watsonboyett/CarTalk/hardware/CarTalk.brd

## EAGLE design hardware/CarTalk.brd (2017-12-25)

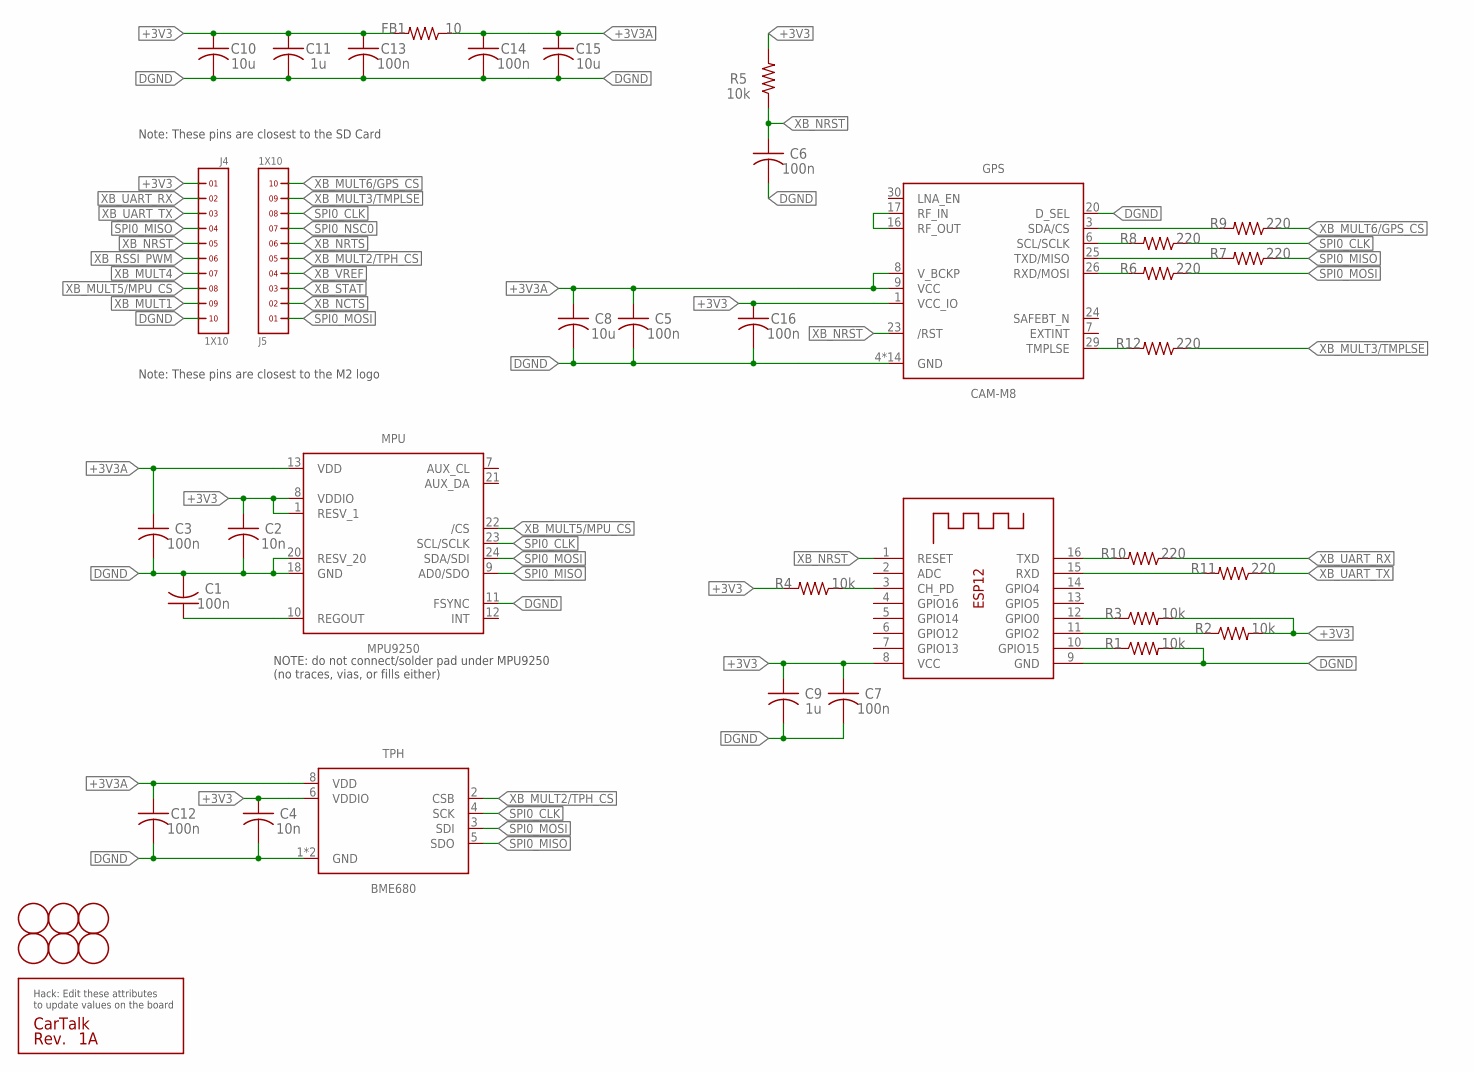
[picture p1: schematic CarTalk.sch]

Parts:
C1, C3, C5, C6, C7, C12, C13, C14, C16: 100n; C0603
C2, C4: 10n; C0603
C8, C10, C15: 10u; C0805
C9, C11: 1u; C0603
FB1: 10; R0603
GPS: CAM-M8
J4, J5: 1X10
MPU: MPU9250; QFN24-NP
R1, R2, R3, R4, R5: 10k; R0603
R6, R7, R8, R9, R10, R11, R12: 220; R0603
TPH: BME680; BME-DFN8
U$5: SILK_QC
U$6, U$7, U$8, U$9, U$10, U$11: FIDUCIAL; FIDUCIAL_1MM
WIFI: ESP-12

Connections:
+3V3: C2.1, C4.1, C7.1, C9.1, C10.1, C11.1, C13.1, C16.1, FB1.2, GPS.1 (VCC_IO), J4.1, MPU.1 (RESV_1), MPU.8 (VDDIO), R1.2, R2.2, R4.2, R5.2, TPH.6 (VDDIO), WIFI.8 (VCC)
+3V3A: C3.1, C5.1, C8.1, C12.1, C14.1, C15.1, FB1.1, GPS.8 (V_BCKP), GPS.9 (VCC), MPU.13 (VDD), TPH.8 (VDD)
DGND: C1.2, C2.2, C3.2, C4.2, C5.2, C6.2, C7.2, C8.2, C9.2, C10.2, C11.2, C12.2, C13.2, C14.2, C15.2, C16.2, GPS.4 (GND), GPS.5 (GND), GPS.10 (GND), GPS.11 (GND), GPS.12 (GND), GPS.13 (GND), GPS.14 (GND), GPS.15 (GND), GPS.18 (GND), GPS.19 (GND), GPS.20 (D_SEL), GPS.21 (GND), GPS.22 (GND), GPS.27 (GND), GPS.31 (GND), J4.10, MPU.11 (FSYNC), MPU.18 (GND), MPU.20 (RESV_20), R3.2, TPH.1 (GND), TPH.7 (GND), WIFI.9 (GND)
unnamed: C1.1, MPU.10 (REGOUT)
unnamed: R1.1, WIFI.12 (GPIO0)
unnamed: R2.1, WIFI.11 (GPIO2)
unnamed: R3.1, WIFI.10 (GPIO15)
unnamed: R4.1, WIFI.3 (CH_PD)
unnamed: GPS.26 (RXD/MOSI), R6.2
unnamed: GPS.25 (TXD/MISO), R7.2
unnamed: GPS.6 (SCL/SCLK), R8.2
unnamed: GPS.3 (SDA/CS), R9.2
unnamed: GPS.16 (RF_OUT), GPS.17 (RF_IN)
unnamed: R10.2, WIFI.16 (TXD)
unnamed: R11.2, WIFI.15 (RXD)
unnamed: GPS.29 (TMPLSE), R12.2
SPI0_CLK: J5.8, MPU.23 (SCL/SCLK), R8.1, TPH.4 (SCK)
SPI0_MISO: J4.4, MPU.9 (AD0/SDO), R7.1, TPH.5 (SDO)
SPI0_MOSI: J5.1, MPU.24 (SDA/SDI), R6.1, TPH.3 (SDI)
SPI0_NSC0: J5.7
XB_MULT1: J4.9
XB_MULT2/TPH_CS: J5.5, TPH.2 (CSB)
XB_MULT3/TMPLSE: J5.9, R12.1
XB_MULT4: J4.7
XB_MULT5/MPU_CS: J4.8, MPU.22 (/CS)
XB_MULT6/GPS_CS: J5.10, R9.1
XB_NCTS: J5.2
XB_NRST: C6.1, GPS.23 (/RST), J4.5, R5.1, WIFI.1 (RESET)
XB_NRTS: J5.6
XB_RSSI_PWM: J4.6
XB_STAT: J5.3
XB_UART_RX: J4.2, R10.1
XB_UART_TX: J4.3, R11.1
XB_VREF: J5.4

Notes on the sheet:
Note: These pins are closest to the SD Card
Note: These pins are closest to the M2 logo
NOTE: do not connect/solder pad under MPU9250 (no traces, vias, or fills either)

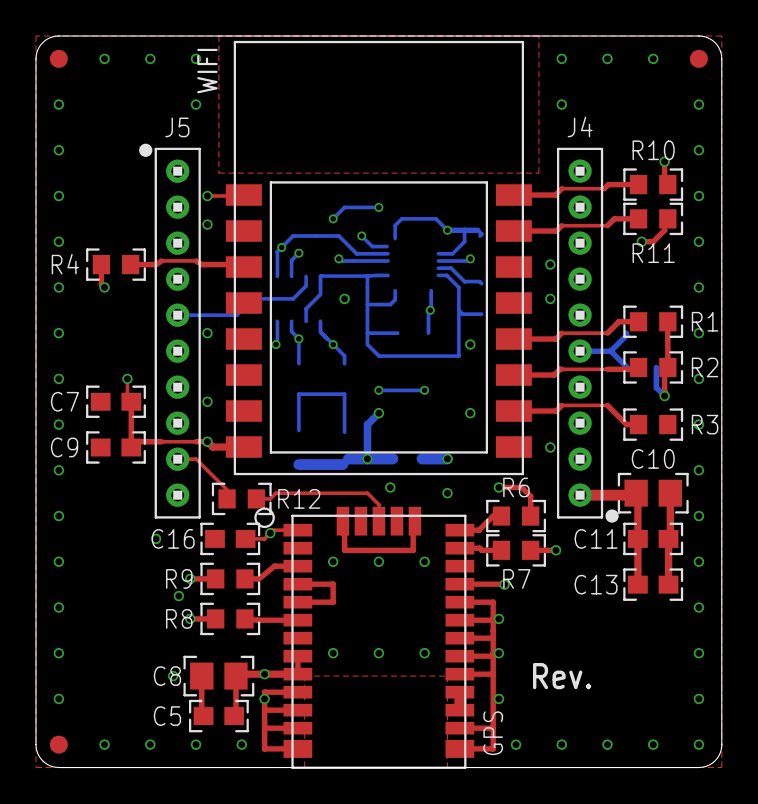
[picture p2: board CarTalk.brd from above]

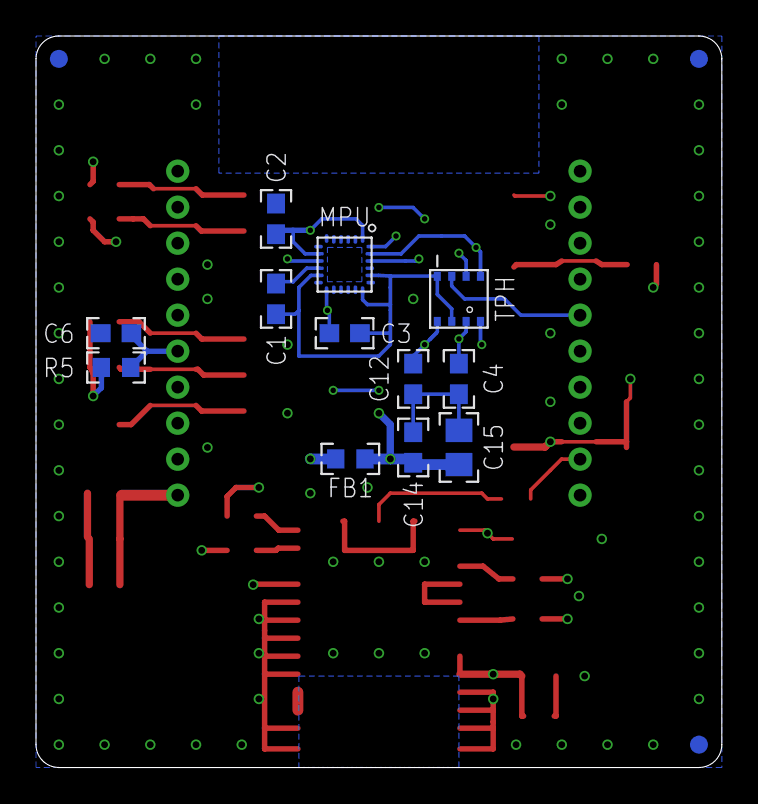
[picture p3: board CarTalk.brd from below]

Board: 4 copper layers, 38.1 x 40.6 mm, 42 parts (15 on the bottom side), 26 nets.
