watsonboyett/CarTalk/(commit log)

2017-07-06 Added initial PCB and mechanical dimensions.
    [CarTalkImu.brd, CarTalkImu.sch]
2017-07-08 Finalized Rev 1A schematic and layout.
    [CarTalkImu.brd, CarTalkImu.sch]
2017-07-20 Re-finalized design and layout.
    [CarTalkImu.brd, CarTalkImu.sch]
2017-09-29 Simplified board layout a bit.
    [CarTalkImu.brd]
2017-12-25 Replaced LPS22 part with BME680 part. Upated board layout.
    [CarTalkImu.brd, CarTalkImu.sch]
2017-12-25 Fixed minor layout/DFM issues
    [CarTalkImu.brd, CarTalkImu.sch]
2017-12-25 Renamed files to match project name
    [CarTalk v1A - BOM.csv, CarTalk.brd, CarTalk.sch, CarTalkImu.sch]
