watsonboyett/CarTalk/(notices)

Notices in the files:
hardware/CarTalk.sch:
CONTACT_ADDRESS: Licensed under CC-BY-SA
CONTACT_PHONE: (Creative Commons, Attribution + Share Alike)
